tadorne-org/penon/site/content/en/_index.md

---
title: "Penon"
translationKey: home
description: "A no-moving-parts ultrasonic wind sensor, published as a commons. A Tadorne project."
params:
  hero:
    eyebrow: "A Tadorne project"
    lead: "The masthead wind sensor with no moving parts, corrected for the boat's motion. Open hardware, down to the silicon."
    ctas:
      - label: "The project"
        url: "/project/"
      - label: "Kit — coming soon"
        url: "mailto:contact@tadorne.org?subject=Penon%20%E2%80%94%20kit%20coming%20soon&body=Hello%2C%0A%0AI%27d%20be%20interested%20in%20the%20Penon%20kit%20when%20it%20becomes%20available.%0A%0AThanks."
        solid: true
  video:
    src: "/video/penon-rugged-en.mp4"
    poster: "/video/penon-rugged-en.webp"
    label: "Animated exploded view of the Penon wind sensor on its mast housing"
    caption: "Exploded view — rugged housing on a Ø50 mast. Electronics coming soon; figures are targets."
  figures:
    - label: "Moving parts"
      value: "0"
    - label: "Principle"
      value: "Ultrasound"
    - label: "Inertial unit"
      value: "Real time"
    - label: "Horizon"
      value: "Open silicon"
    - label: "Licence"
      value: "Free"
  notes:
    - title: "Bench first"
      body: "The physics is measured before anything is frozen."
    - title: "Open calibration"
      body: "The method nobody publishes — published."
    - title: "A reusable block"
      body: "The measurement core returns to open silicon, for more than wind."
  closing:
    title: "Join Penon"
    body: "Beta testers and contributors wanted. The bench is open; the mast comes this winter."
    url: "mailto:contact@tadorne.org?subject=Penon%20%E2%80%94%20beta%20testing%20%2F%20contribution&body=Hello%2C%0A%0AI%20would%20like%20to%20get%20involved%20in%20Penon.%0A%0AWhat%20I%20can%20bring%3A%0A-%0A%0AWhat%20I%20am%20looking%20for%3A%0A-%0A%0AThanks."
    label: "Write to us"
---

Wind, read in an ultrasonic field. Nothing to seize, nothing to wear.

The kit isn't available yet. Want to be notified? Get in touch at `contact@tadorne.org`.
