tadorne-org/penon/site/content/en/roadmap.md

---
title: "Roadmap"
translationKey: roadmap
url: /roadmap/
type: roadmap
description: "Eight milestones, published as they land."
params:
  milestones:
    - id: "M1"
      title: "Bench validated"
      body: "Resonance measured: frequency, quality factor, phase slope. Rig and method published."
    - id: "M2"
      title: "Prototypes"
      body: "Machined parts, revised board, ten assembled units."
    - id: "M3"
      title: "Open calibration"
      body: "Rig and correction tables, reproducible by third parties."
    - id: "M4"
      title: "Firmware v1"
      body: "Measurement, servo, motion compensation, quality flag."
    - id: "M5"
      title: "Measurement campaign"
      body: "Against a reference sensor; open dataset and accuracy report."
    - id: "M6"
      title: "RTL + FPGA"
      body: "The whole measurement chain validated on the real cavity, free toolchain."
    - id: "M7"
      title: "First silicon"
      body: "Shared-shuttle tapeout in an open process, analogue front-end on the die."
    - id: "M8"
      title: "Characterised IP block"
      body: "The phase-measurement core republished as a standalone, reusable block."
---

The physics is fixed first. Silicon starts early, because fabrication takes months.
