tadorne-org/penon/site/content/en/log/aluminium-resonance-cavity.md

---
title: "The aluminium resonance cavity, assembled"
translationKey: log/aluminium-cavity-assembled
date: 2026-10-02
description: "The two machined discs assembled into a cavity."
params:
  tags: ["penon", "mechanics"]
---

The two machined discs form the cavity: standoffs in place, screws around the rim, transducer openings clear. Ready for measurement.

<div class="photo-grid" style="column-width: 20rem">
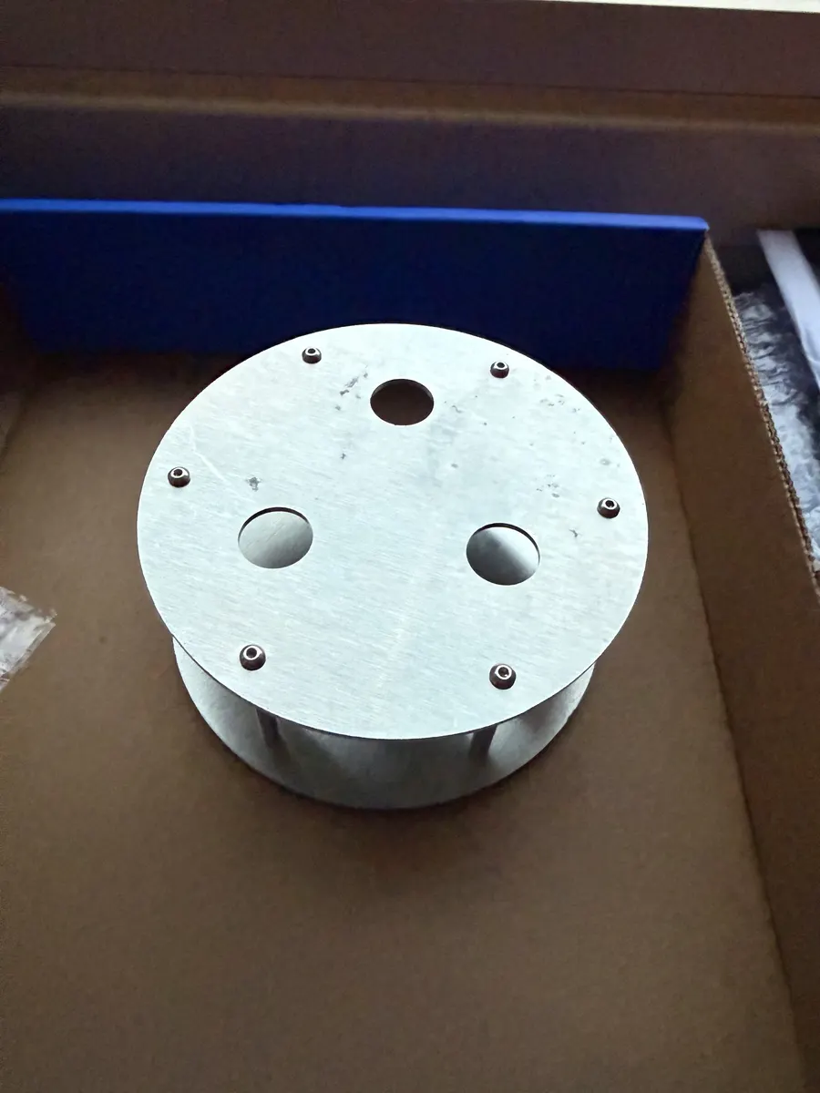
[picture p8: site/static/img/caisse-alu-01.webp]
The cavity seen from above: drilled top disc, screws around the rim.
  
  The assembled cavity at an angle: both discs and their standoffs.
</div>
