tadorne-org/penon/site/content/en/log/bench-first.md

---
title: "Bench first"
translationKey: log/bench-first
date: 2026-09-10
description: "The project opens at the bench, not in the water."
params:
  tags: ["penon", "measurement"]
---

The cavity goes under measurement first — frequency, quality factor, phase slope. The rig, the numbers and the failures will be published here.

<div class="photo-grid">
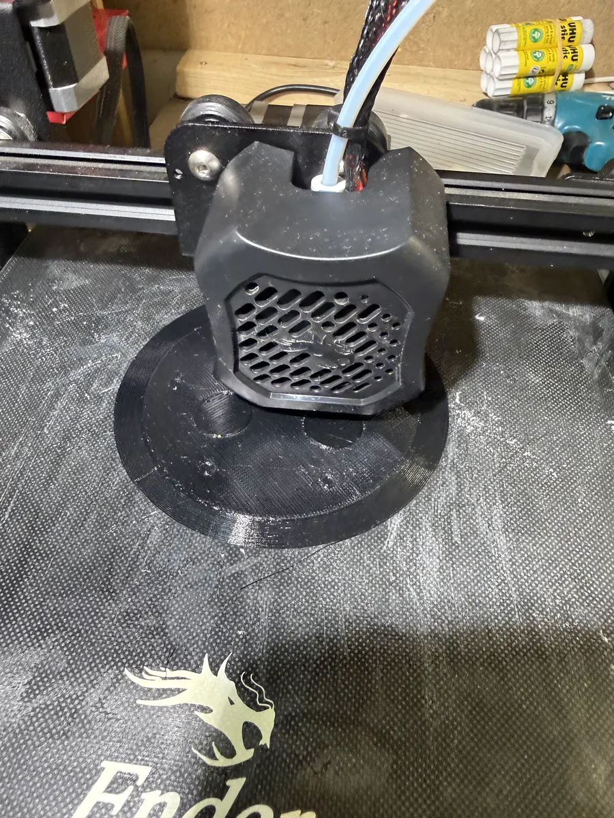
[picture p9: site/static/img/prototype-01.webp]
A printed disc on the 3D printer bed.
  
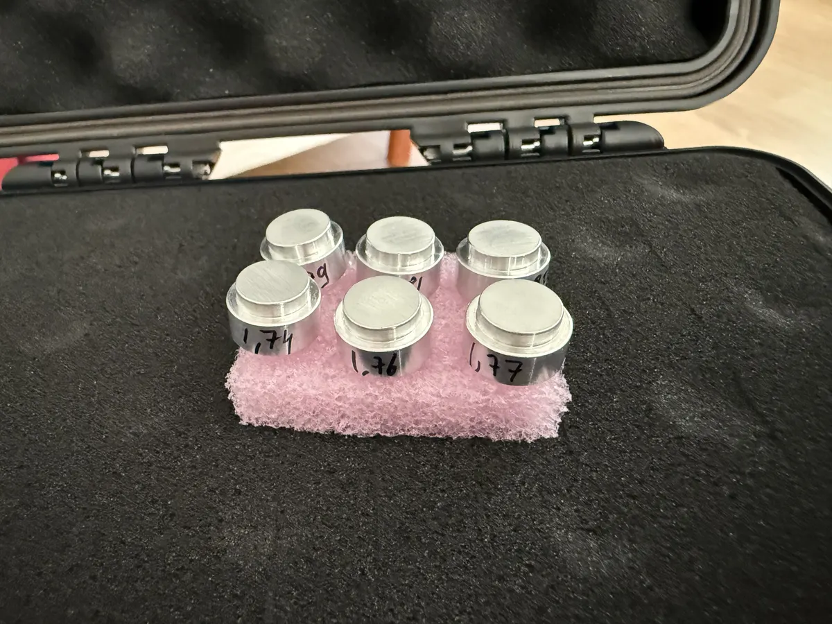
[picture p10: site/static/img/prototype-02.webp]
Six matched transducers, stored in their case.
  
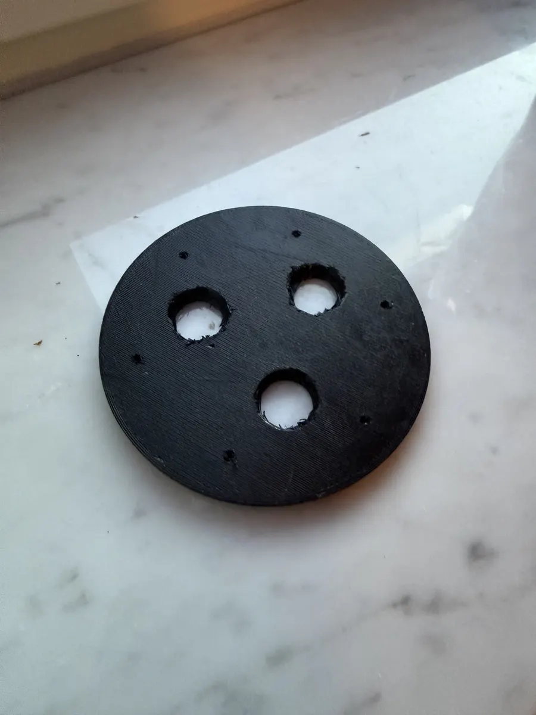
[picture p11: site/static/img/prototype-03.webp]
A printed disc, drilled for the transducers.
  
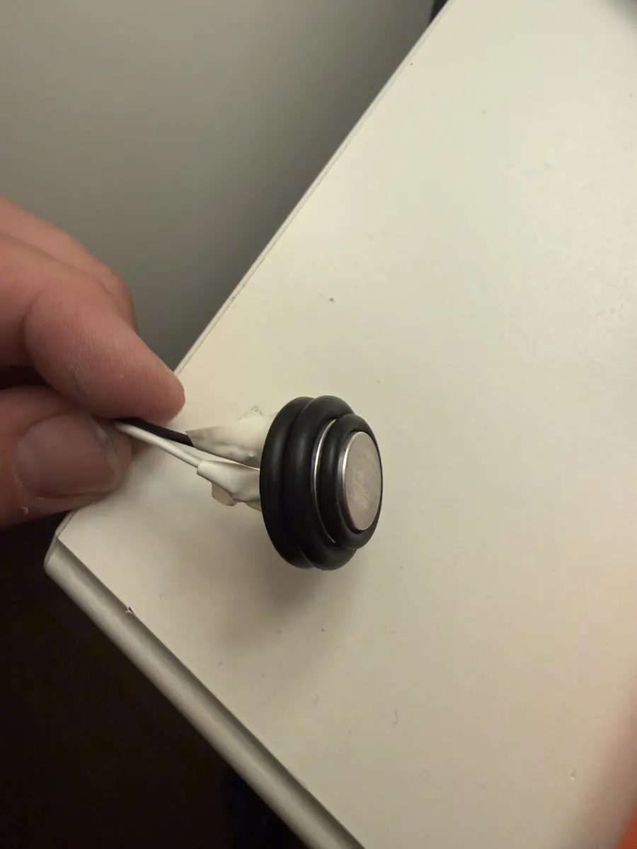
[picture p12: site/static/img/prototype-04.webp]
A transducer fitted into its printed ring.
  
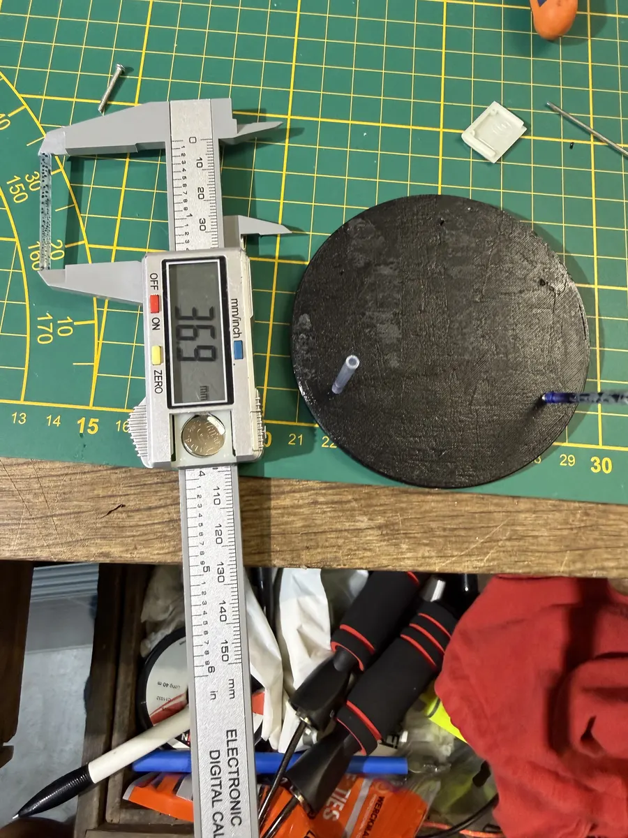
[picture p13: site/static/img/prototype-05.webp]
A printed disc checked with calipers.
  
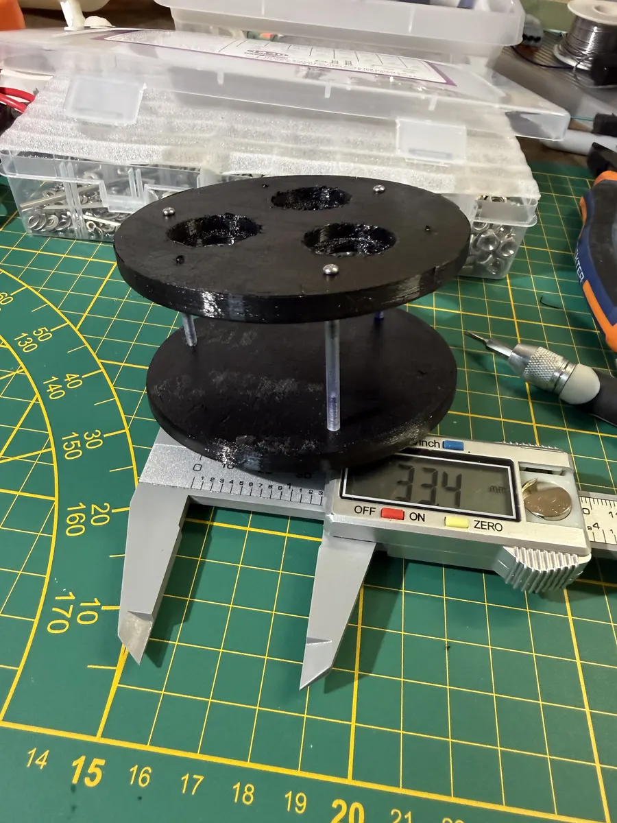
[picture p14: site/static/img/prototype-06.webp]
The two discs assembled on standoffs, measured with calipers.
  
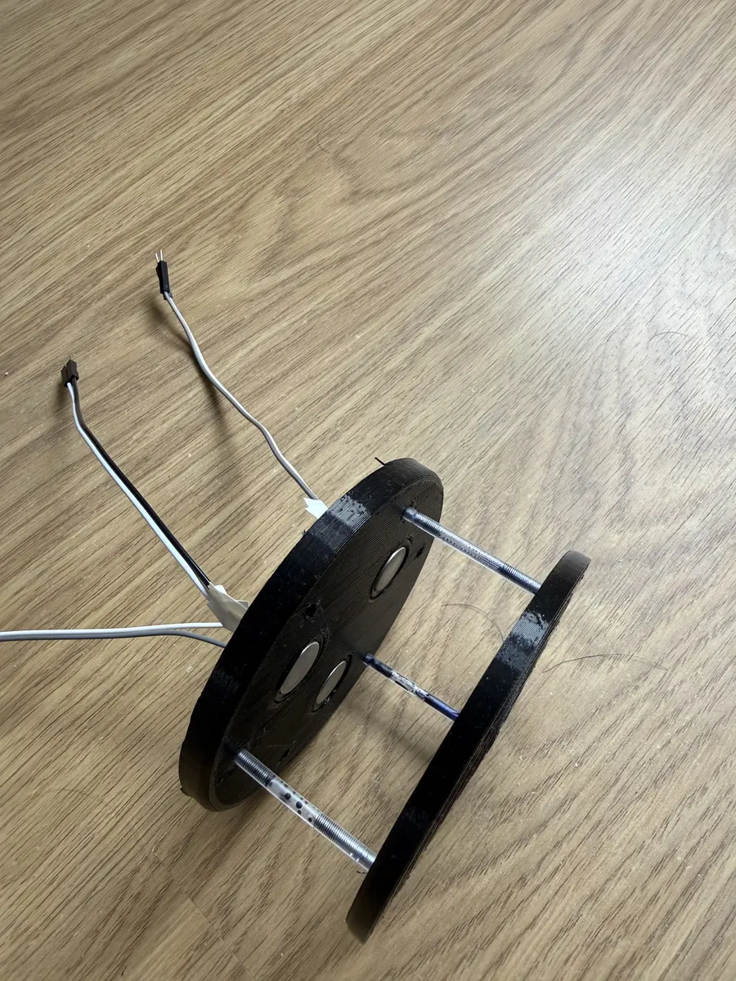
[picture p15: site/static/img/prototype-07.webp]
The wired assembly on the bench.
  
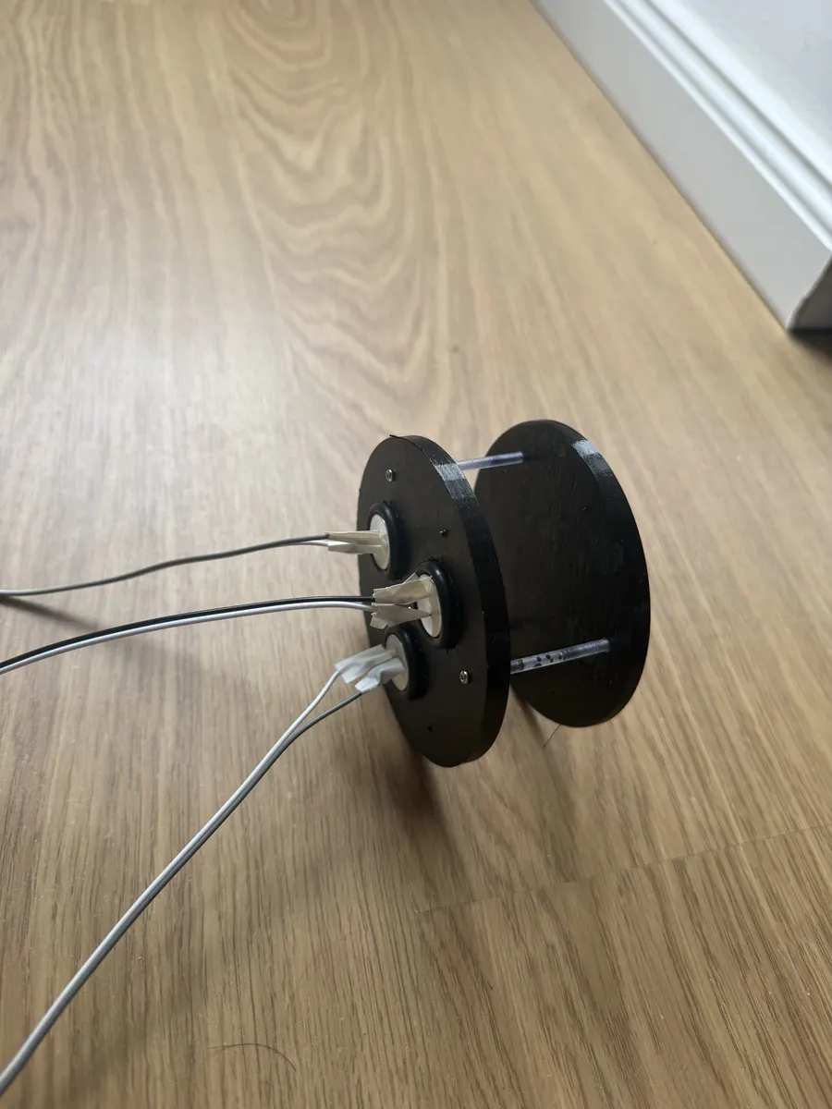
[picture p16: site/static/img/prototype-08.webp]
Three transducers bonded into the disc, wired.
  
</div>
