tadorne-org/penon/site/content/en/log/hardened-housing.md

---
title: "A hardened housing, printed in PETG"
translationKey: log/hardened-housing
date: 2026-10-05
description: "A ribbed housing, printed in PETG, replacing the broken structure."
params:
  tags: ["penon", "mechanics"]
---

The previous structure broke: too fragile. The new one is hardened — six ribs carry the crown down to the mast socket foot, with no cantilever left — and prints in PETG, inverted on the bed.

<div class="photo-grid">
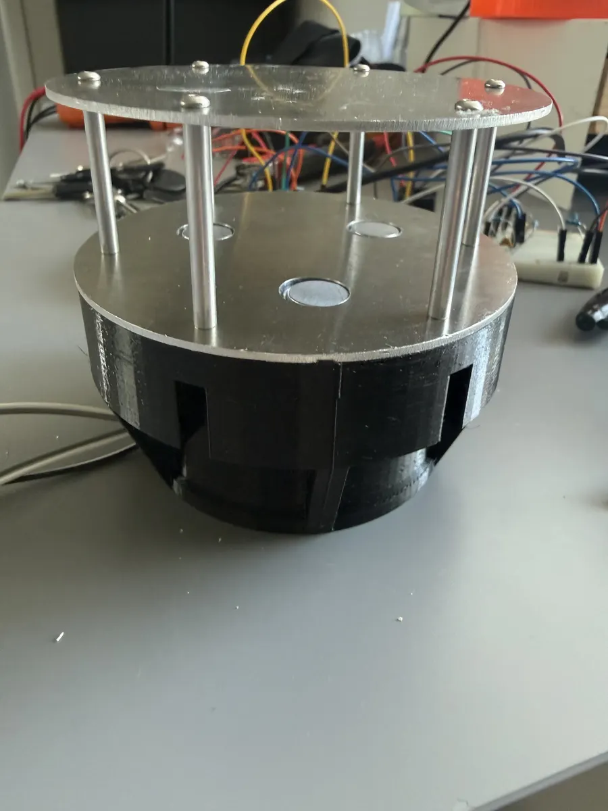
[picture p17: site/static/img/structure-durcie-01.webp]
The aluminium cavity mounted on the new ribbed housing.
  
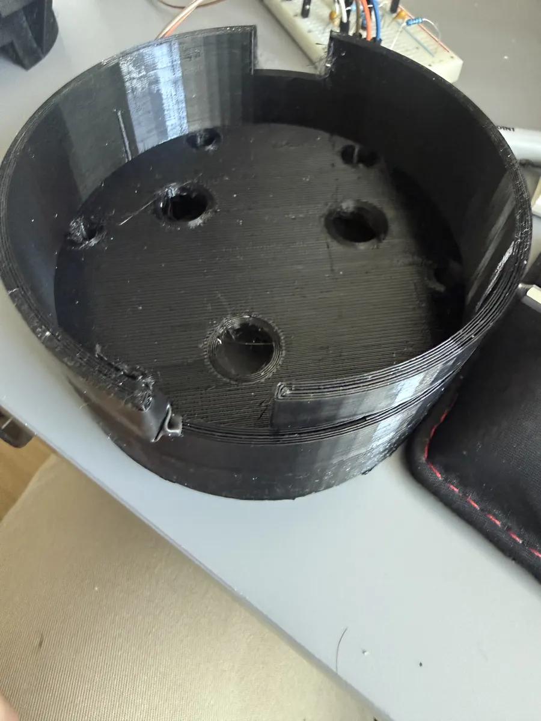
[picture p18: site/static/img/structure-durcie-02.webp]
The printed housing from above: transducer seats and ribs.
  
  The housing at an angle: the ribs carrying the crown down to the foot.
</div>
