tadorne-org/penon/site/content/en/log/resonance-frequency-search.md

---
title: "First tests on the resonance frequency and Q"
translationKey: log/resonance-frequency-search
date: 2026-09-16
description: "A frequency sweep on the printed cavity, signal picked up on the oscilloscope."
params:
  tags: ["penon", "measurement"]
---

The printed cavity goes on the bench: a frequency sweep around 40 kHz, the signal picked up on the oscilloscope. What remains is the resonance curve and Q.

<figure>
  The bench: printed cavity, breadboard and oscilloscope showing the drive signal.
</figure>

<figure>
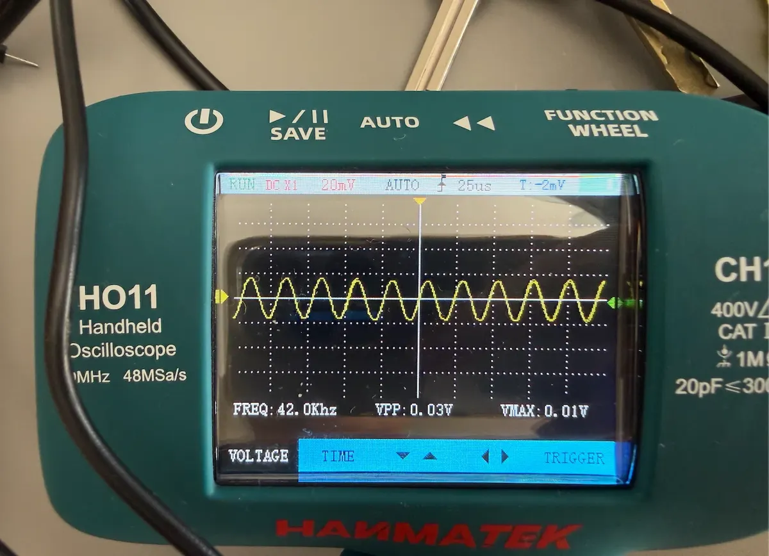
[picture p22: site/static/img/resonance-02.webp]
The oscilloscope screen showing the received signal, a sine wave.
  
</figure>
