tadorne-org/penon/site/content/en/log/thermal-drift.md

---
title: "Thermal drift measured: 75 Hz/°C"
translationKey: log/thermal-drift
date: 2026-10-04
description: "The resonance follows temperature at 75 Hz/°C."
params:
  tags: ["penon", "measurement"]
---

One night of recording, with no mechanical intervention: the resonance follows the room temperature at 75 Hz/°C, where the model predicted 70 — with no fitted parameter. Residuals fall to the level of the bench's measurement floor: the relation is explained down to what the instrument can resolve.

<figure>
  Two panels: on the left the resonance frequency and temperature through the night; on the right frequency against temperature with the regression.
</figure>
