tadorne-org/penon/site/content/en/log/tpu-sole.md

---
title: "The TPU sole is ready"
translationKey: log/tpu-sole
date: 2026-10-07
description: "TPU tuning, sole printed; on to the bench."
params:
  tags: ["penon", "mechanics"]
---

After several TPU-specific adjustments, the sole prints very satisfactorily. On to the bench tests.

<div class="photo-grid">
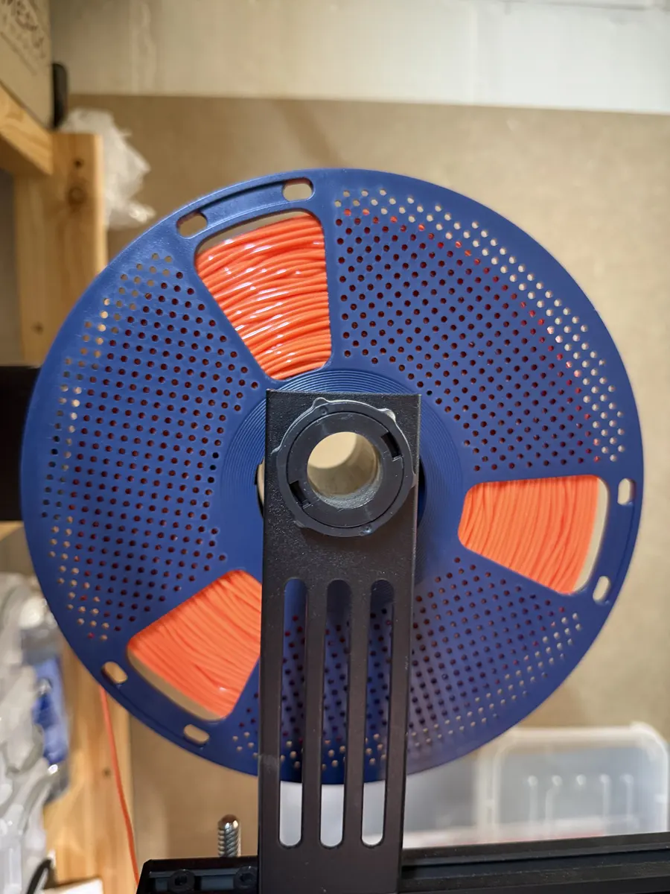
[picture p23: site/static/img/semelle-tpu-01.webp]
The orange TPU spool on its holder.
  
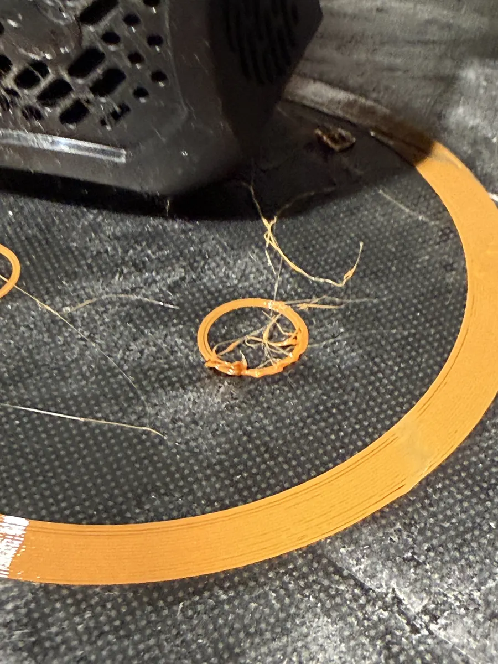
[picture p24: site/static/img/semelle-tpu-02.webp]
First attempt: strings and blobs on the bed.
  
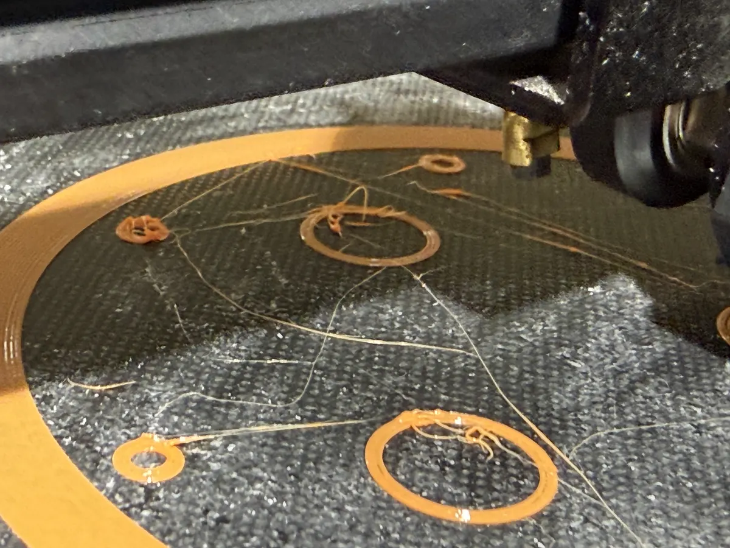
[picture p25: site/static/img/semelle-tpu-03.webp]
The bed after an attempt: several parts and a lot of stringing.
  
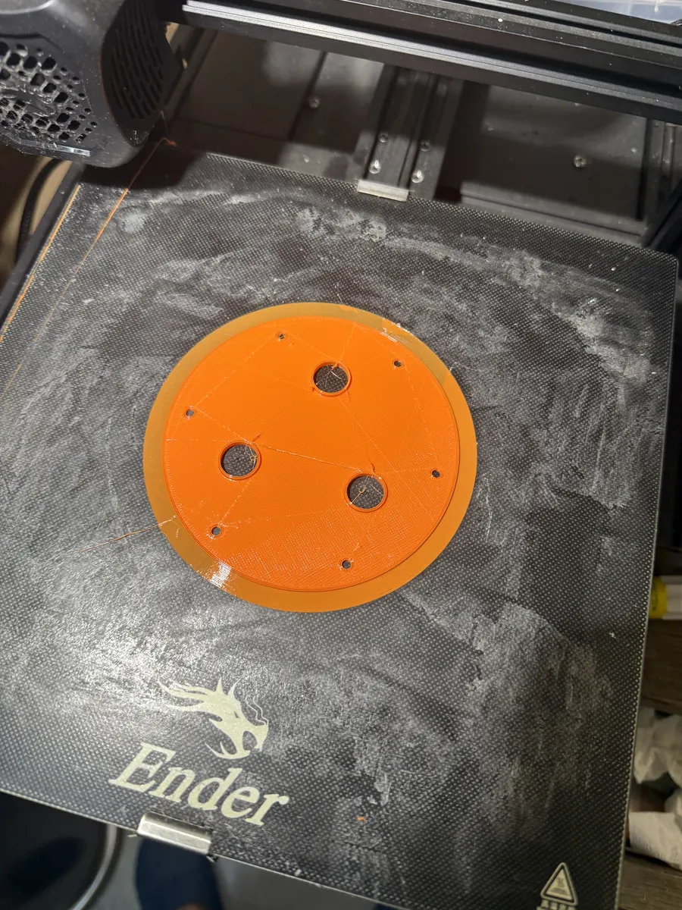
[picture p26: site/static/img/semelle-tpu-04.webp]
The sole being printed on the bed.
  
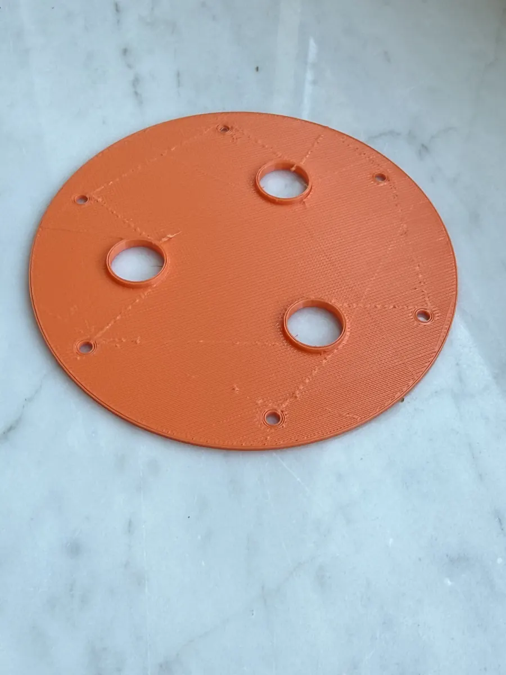
[picture p27: site/static/img/semelle-tpu-05.webp]
The finished TPU sole, on the marble.
  
  The sole in place between the aluminium cavity and the housing.
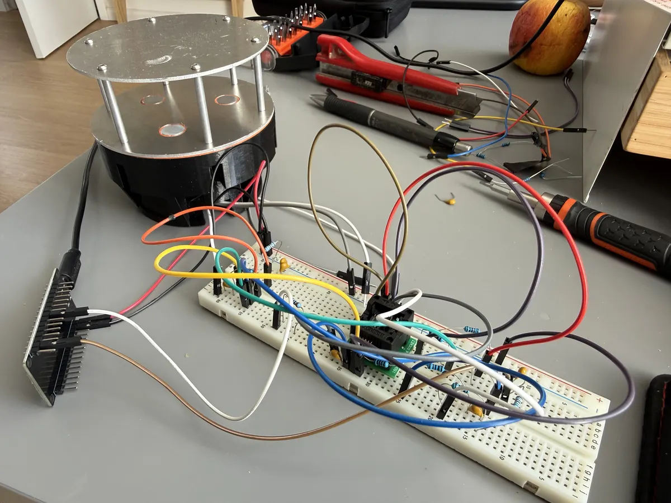
[picture p28: site/static/img/semelle-tpu-07.webp]
The full bench, ready for testing.
  
</div>
