tadorne-org/penon/site/content/en/log/why-open-silicon.md

---
title: "Why open silicon"
translationKey: log/why-open-silicon
date: 2026-09-08
description: "A measurement core that one supplier could retire."
params:
  tags: ["penon", "silicon"]
---

The measurement chain rests on parts a single supplier can discontinue. The answer is a free, characterised core — reused far beyond wind.
