tadorne-org/penon/site/content/en/about.md

---
title: "About"
translationKey: about
url: /about/
description: "Penon is a Tadorne project."
---

**Tadorne** — *duck engineering* — designs and publishes open hardware: electronics, mechanics, firmware, silicon. Penon is its first project.

Everything published is signed with a single GPG key, anchored in the DNS of `tadorne.org`:

<code class="fingerprint">5420 08E3 53EC A628 B4D6  ACAD 8C03 243A FF69 5BF7</code>

[How to verify a publication](https://tadorne.org/verify/) · `contact@tadorne.org`
