tadorne-org/penon/site/content/fr/_index.md

---
title: "Penon"
translationKey: home
description: "Anémomètre ultrasonique sans pièce mobile, publié comme un commun. Un projet Tadorne."
params:
  hero:
    eyebrow: "Un projet Tadorne"
    lead: "L'anémomètre de tête de mât sans aucune pièce mobile, corrigé du mouvement du bateau. Matériel libre, jusqu'au silicium."
    ctas:
      - label: "Le projet"
        url: "/fr/projet/"
      - label: "Kit — bientôt disponible"
        url: "mailto:contact@tadorne.org?subject=Penon%20%E2%80%94%20kit%20%C3%A0%20venir&body=Bonjour%2C%0A%0AJe%20serais%20int%C3%A9ress%C3%A9%20par%20le%20kit%20Penon%20lorsqu%27il%20sera%20disponible.%0A%0AMerci."
        solid: true
  video:
    src: "/video/penon-durci-fr.mp4"
    poster: "/video/penon-durci-fr.webp"
    label: "Vue éclatée animée de l'anémomètre Penon sur son boîtier de mât"
    caption: "Vue éclatée — boîtier durci sur mât Ø50. Électronique à venir ; les chiffres sont des objectifs."
  figures:
    - label: "Pièces mobiles"
      value: "0"
    - label: "Principe"
      value: "Ultrasons"
    - label: "Centrale inertielle"
      value: "Temps réel"
    - label: "Horizon"
      value: "Silicium libre"
    - label: "Licence"
      value: "Libre"
  notes:
    - title: "Le banc d'abord"
      body: "La physique est mesurée avant d'être figée."
    - title: "Étalonnage ouvert"
      body: "La méthode que personne ne publie — publiée."
    - title: "Un bloc réutilisable"
      body: "Le cœur de mesure retourne au silicium libre, au-delà du vent."
  closing:
    title: "Rejoindre Penon"
    body: "Bêta-testeurs et contributeurs recherchés. Le banc est ouvert, le mât vient cet hiver."
    url: "mailto:contact@tadorne.org?subject=Penon%20%E2%80%94%20b%C3%AAta-test%20%2F%20contribution&body=Bonjour%2C%0A%0AJe%20souhaite%20m%27impliquer%20dans%20Penon.%0A%0ACe%20que%20je%20peux%20apporter%20%3A%0A-%0A%0ACe%20que%20je%20cherche%20%3A%0A-%0A%0AMerci."
    label: "Écrire"
---

Le vent, lu dans un champ ultrasonore. Rien qui se grippe, rien qui s'use.

Le kit n'est pas encore disponible. Vous souhaitez être prévenu ? Contactez-nous à `contact@tadorne.org`.
