tadorne-org/penon/site/content/fr/a-propos.md

---
title: "À propos"
translationKey: about
url: /fr/a-propos/
description: "Penon est un projet Tadorne."
---

**Tadorne** — *duck engineering* — conçoit et publie du matériel libre : électronique, mécanique, micrologiciel, silicium. Penon est son premier projet.

Tout ce qui est publié est signé par une clé GPG unique, ancrée dans le DNS de `tadorne.org` :

<code class="fingerprint">5420 08E3 53EC A628 B4D6  ACAD 8C03 243A FF69 5BF7</code>

[Comment vérifier une publication](https://tadorne.org/verifier/) · `contact@tadorne.org`
