tadorne-org/penon/site/content/fr/feuille-de-route.md

---
title: "Feuille de route"
translationKey: roadmap
url: /fr/feuille-de-route/
type: roadmap
description: "Huit jalons, publiés au fur et à mesure."
params:
  milestones:
    - id: "M1"
      title: "Banc validé"
      body: "Résonance mesurée : fréquence, facteur de qualité, pente de phase. Banc et méthode publiés."
    - id: "M2"
      title: "Prototypes"
      body: "Pièces usinées, carte révisée, dix exemplaires assemblés."
    - id: "M3"
      title: "Étalonnage ouvert"
      body: "Platine et tables de correction, reproductibles par des tiers."
    - id: "M4"
      title: "Micrologiciel v1"
      body: "Mesure, asservissement, compensation du mouvement, drapeau de qualité."
    - id: "M5"
      title: "Campagne de mesure"
      body: "Face à un capteur de référence ; jeu de données ouvert et rapport de précision."
    - id: "M6"
      title: "RTL + FPGA"
      body: "Toute la chaîne de mesure validée sur la cavité réelle, chaîne d'outils libre."
    - id: "M7"
      title: "Premier silicium"
      body: "Tapeout en navette partagée sur procédé ouvert, front-end analogique sur la puce."
    - id: "M8"
      title: "Bloc IP caractérisé"
      body: "Le cœur de mesure de phase republié en bloc autonome et réutilisable."
---

La physique est figée d'abord. Le silicium démarre tôt, la fabrication prenant des mois.
