tadorne-org/penon/site/content/fr/projet.md

---
title: "Le projet"
translationKey: project
url: /fr/projet/
description: "Un capteur de vent sans pièce mobile, et une route vers le silicium libre."
params:
  eyebrow: "Penon"
---

## Le problème

Un capteur de tête de mât est une pièce qui casse — et le marché qui le remplace est fermé.

## L'approche

Le vent se lit dans la manière dont il perturbe un champ ultrasonore entre des transducteurs fixes. La mesure est réciproque : le milieu s'annule, il reste le vent. Rien ne bouge.

## Le mouvement

Une tête de mât bouge — roulis, tangage, accélération. Une centrale inertielle embarquée corrige la mesure en temps réel : ce qui arrive au barreur est le vent, pas le mouvement du bateau.

## L'horizon

Un instrument ouvert de bout en bout — et, au bout du chemin, les puces à signaux mixtes qui en forment le cœur, refaites en silicium libre. Le cœur de mesure retourne aux communs comme bloc réutilisable.

## Licence

Annoncée à la première publication. Visées : licences libres, matériel et micrologiciel.
