tadorne-org/penon/site/content/en/log/first-prototype-parts.md

---
title: "First prototype parts"
translationKey: log/first-prototype-parts
date: 2026-09-10
description: "The first resonance prototype discs come off the printer."
params:
  viewer: true
  tags: ["penon", "resonance", "prototype"]
---

The first prototype discs are printed in PETG. The cavity goes to the bench
as soon as the transducers are in place.

{{< viewer src="/models/disque_bas_proto.glb" label="Lower disc — three transducer bores" >}}

{{< viewer src="/models/disque_haut_proto.glb" label="Upper disc — reflector" >}}

{{< viewer src="/models/eclate_cusa.glb" label="Exploded view — transducer and O-rings" >}}

{{< photo src="img/journal/lot-usine.png" alt="Six machined aluminium parts on pink foam in a case" caption="The machined batch, measured one by one." >}}

{{< photo src="img/journal/impression-disque.png" alt="A black PETG disc on the printer bed" caption="The lower disc on the bed." >}}

{{< photo src="img/journal/disque-transducteurs.png" alt="Printed disc with three transducers fitted flush" caption="Printed disc, transducers in place." >}}
