tadorne-org/penon/site/content/en/log/first-print.md

---
title: "First 3D print of a time-of-flight version"
translationKey: log/3d-printed-prototype
date: 2026-08-26
description: "The prototype comes off the printer."
params:
  tags: ["penon", "mechanics"]
---

<figure>
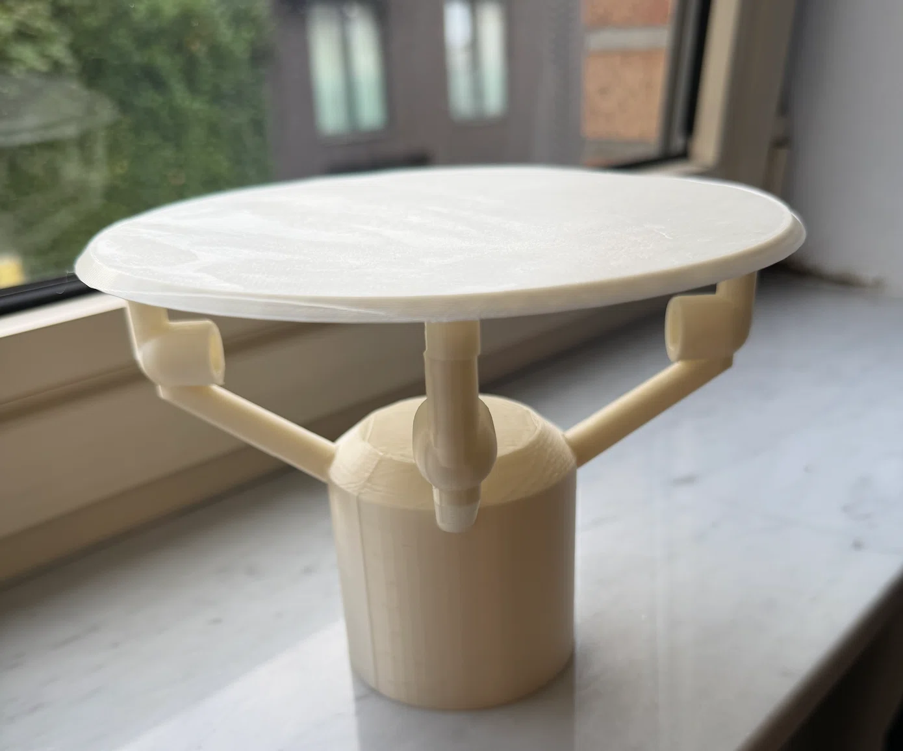
[picture p29: site/static/img/prototype.webp]
A 3D-printed mechanical prototype resting on a window sill.
  
</figure>

The prototype, the failures and the corrections will be published here.
