tadorne-org/penon/site/content/en/log/first-bench-results.md

---
title: "First bench results: Q = 287"
translationKey: log/bench-results-q
date: 2026-10-02
description: "Q measured at 287 on the aluminium cavity — ten times the assumption."
params:
  tags: ["penon", "measurement"]
---

The aluminium cavity resonates at 39.7 kHz with a Q of 287 — ten times the working assumption. Mode spacing returns the mechanical gap with no fitted parameter, and the Lorentzian predicts the off-resonance amplitude to within 2%.

<div class="photo-grid">
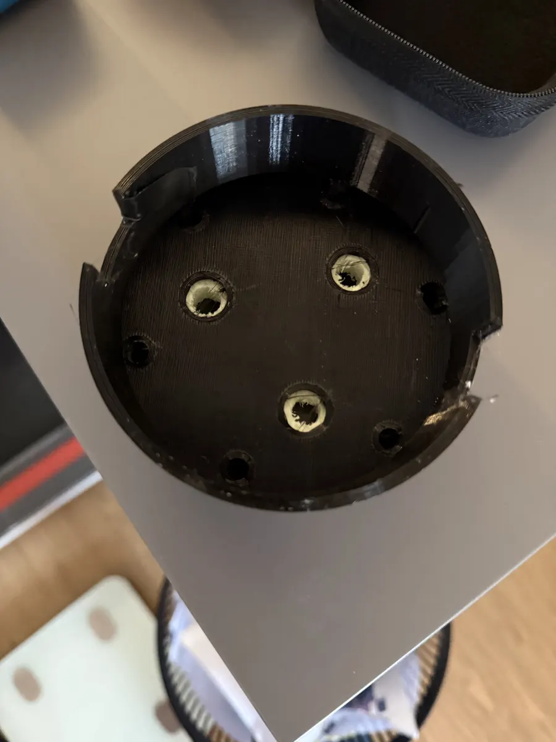
[picture p30: site/static/img/banc-q-01.webp]
The printed housing and its three inserts, seen from above.
  
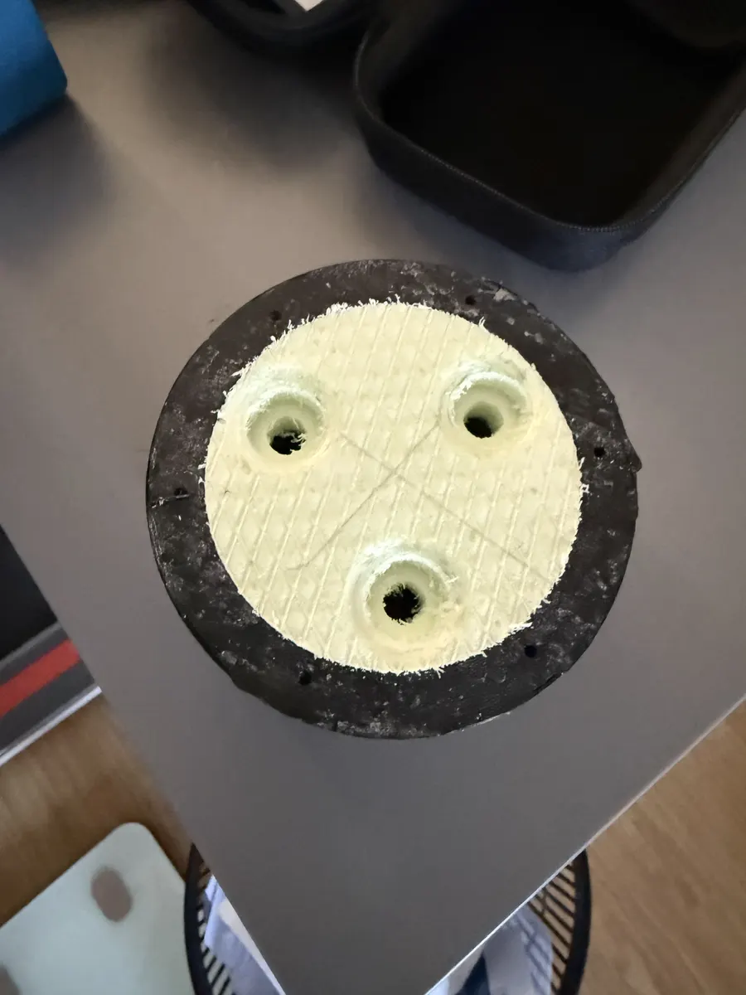
[picture p31: site/static/img/banc-q-02.webp]
The housing lined with foam, drilled for the three transducers.
  
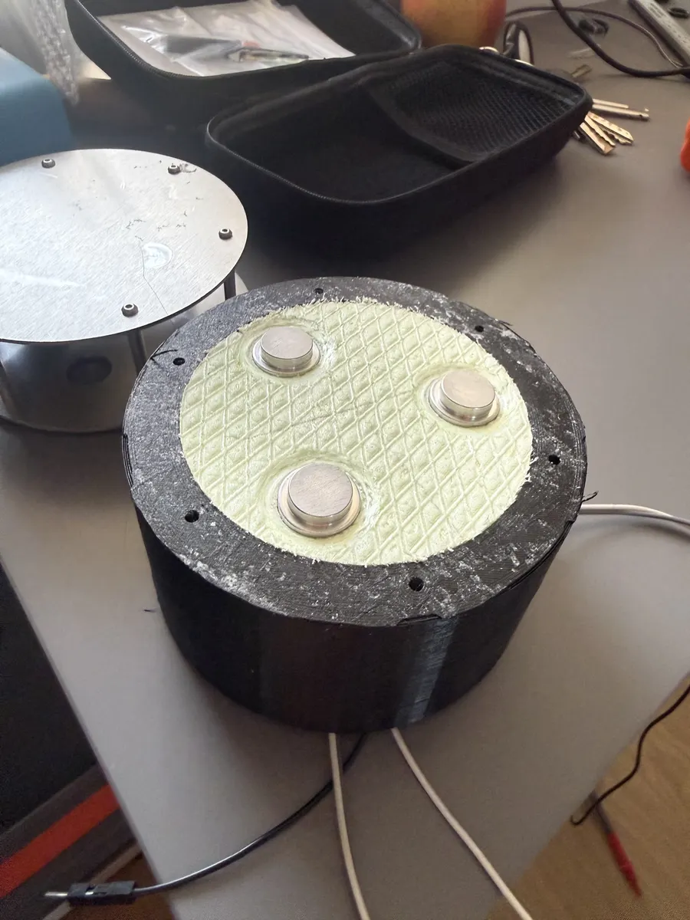
[picture p32: site/static/img/banc-q-03.webp]
The three transducers set in the foam, next to the aluminium cavity.
  
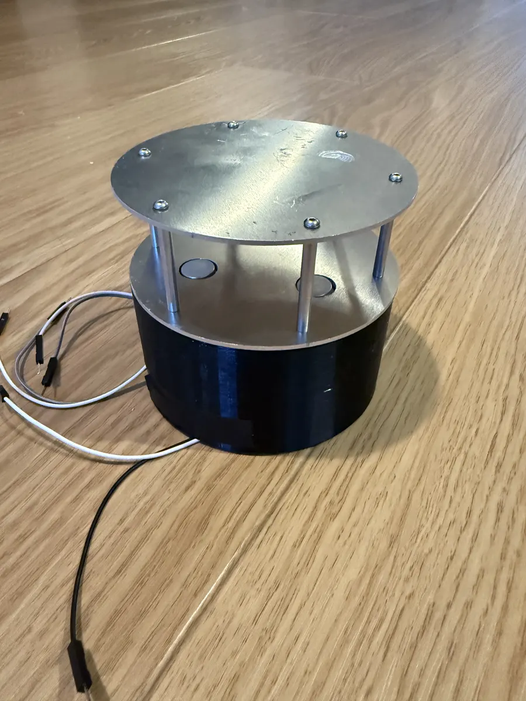
[picture p33: site/static/img/banc-q-04.webp]
The aluminium cavity mounted on the transducer housing.
  
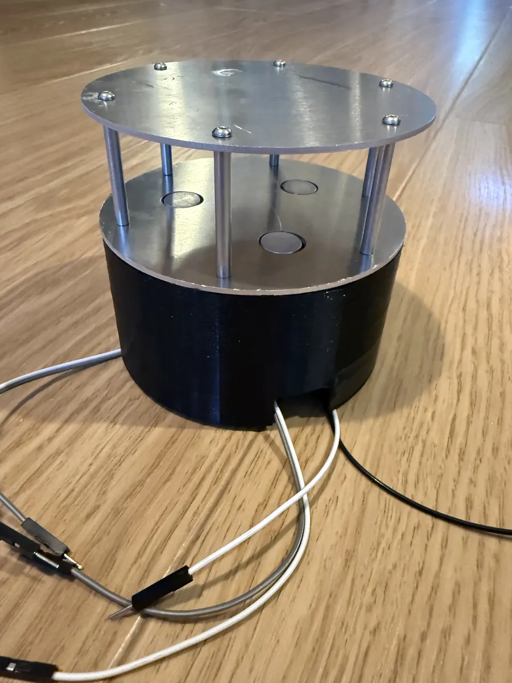
[picture p34: site/static/img/banc-q-05.webp]
The assembled cavity at an angle: discs, standoffs and wiring.
  
  The full bench: cavity, breadboard and oscilloscope.
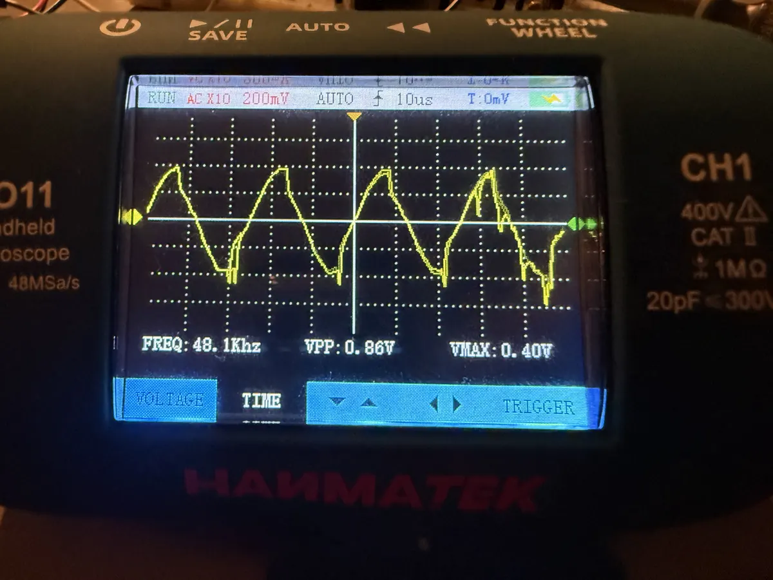
[picture p35: site/static/img/banc-q-07.webp]
The oscilloscope screen: the signal at resonance, with the notch on the falling edge.
  
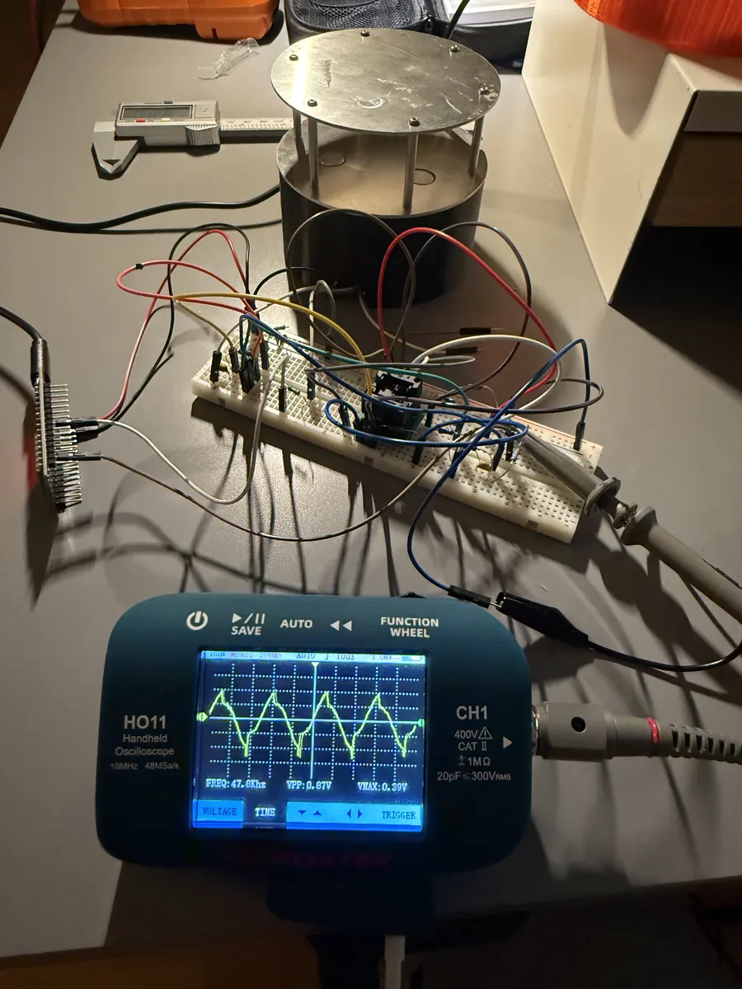
[picture p36: site/static/img/banc-q-08.webp]
The bench from above: cavity, circuit and an off-resonance reading.
  
</div>
