tadorne-org/penon/site/content/en/log/first-opamp-test.md

---
title: "First test with the op-amp"
translationKey: log/opamp-first-test
date: 2026-09-18
description: "The amplification stage on the breadboard."
params:
  tags: ["penon", "measurement"]
---

The amplification stage joins the chain: the whole setup now fits on the breadboard, from drive to reception. First test, first readings.

<figure>
  The breadboard setup: the amplification stage and the links to the cavity.
</figure>
