tadorne-org/penon/site/content/fr/journal/premier-test-ampli-op.md

---
title: "Premier test avec ampli-op"
translationKey: log/opamp-first-test
date: 2026-09-18
description: "L'étage d'amplification monté sur la plaque d'essai."
params:
  tags: ["penon", "mesure"]
---

L'étage d'amplification entre dans la chaîne : le montage complet tient sur la plaque d'essai, de l'émission à la réception. Premier test, premiers relevés.

<figure>
  Le montage sur la plaque d'essai : l'étage d'amplification et les liaisons vers la cavité.
</figure>
