tadorne-org/penon/site/content/fr/journal/premiers-resultats-banc.md

---
title: "Premiers résultats du banc : Q = 287"
translationKey: log/bench-results-q
date: 2026-10-02
description: "Q mesuré à 287 sur la cavité aluminium — dix fois l'hypothèse."
params:
  tags: ["penon", "mesure"]
---

La cavité aluminium résonne à 39,7 kHz, avec un Q de 287 — dix fois l'hypothèse de travail. L'écart entre modes redonne la distance mécanique sans aucun paramètre ajusté, et la lorentzienne prédit l'amplitude hors résonance à 2 % près.

<div class="photo-grid">
  Le logement imprimé et ses trois inserts, vu de dessus.
  Le logement garni de mousse, percé pour les trois sondes.
  Les trois sondes en place dans la mousse, à côté de la cavité aluminium.
  La cavité aluminium montée sur le logement des sondes.
  La cavité assemblée, vue de biais : disques, entretoises et câblage.
  Le banc complet : cavité, plaque d'essai et oscilloscope.
  L'écran de l'oscilloscope : le signal à la résonance, avec le décrochement en descente.
  Le banc vu de dessus : cavité, montage et relevé hors résonance.
</div>
