tadorne-org/penon/site/content/fr/journal/caisse-resonance-alu.md

---
title: "La caisse de résonance assemblée en aluminium"
translationKey: log/aluminium-cavity-assembled
date: 2026-10-02
description: "Les deux disques usinés réunis en caisse."
params:
  tags: ["penon", "mécanique"]
---

Les deux disques usinés forment la caisse : entretoises en place, vis au pourtour, ouvertures des sondes dégagées. Prête pour la mesure.

<div class="photo-grid" style="column-width: 20rem">
  La caisse vue de dessus : disque supérieur percé, vis au pourtour.
  La caisse assemblée vue de biais : les deux disques et leurs entretoises.
</div>
