tadorne-org/penon/site/content/fr/journal/derive-thermique.md

---
title: "Dérive thermique mesurée : 75 Hz/°C"
translationKey: log/thermal-drift
date: 2026-10-04
description: "La résonance suit la température à 75 Hz/°C."
params:
  tags: ["penon", "mesure"]
---

Une nuit d'enregistrement, sans intervention mécanique : la résonance suit la température de la pièce à 75 Hz/°C, quand le modèle en prévoyait 70 — sans aucun paramètre ajusté. Les résidus tombent au niveau du plancher du banc : la relation est expliquée jusqu'à ce que l'instrument sait résoudre.

<figure>
  Deux panneaux : à gauche la fréquence de résonance et la température au fil de la nuit ; à droite la fréquence en fonction de la température, avec la régression.
</figure>
