tadorne-org/penon/site/content/fr/journal/le-banc-d-abord.md

---
title: "Le banc d'abord"
translationKey: log/bench-first
date: 2026-09-10
description: "Le projet s'ouvre à l'établi, pas à l'eau."
params:
  tags: ["penon", "mesure"]
---

La cavité passe d'abord sous la mesure — fréquence, facteur de qualité, pente de phase. Le banc, les chiffres et les ratés seront publiés ici.

<div class="photo-grid">
  Un disque imprimé sur le plateau de l'imprimante 3D.
  Six sondes appariées, rangées dans leur boîte.
  Disque imprimé, percé pour les sondes.
  Une sonde montée dans sa bague imprimée.
  Contrôle au pied à coulisse d'un disque imprimé.
  Les deux disques assemblés sur entretoises, mesurés au pied à coulisse.
  L'assemblage câblé, posé sur l'établi.
  Trois sondes collées dans le disque, câblées.
</div>
