tadorne-org/penon/site/content/fr/journal/premiere-impression.md

---
title: "Première impression 3D d'une version Time Of Flight"
translationKey: log/3d-printed-prototype
date: 2026-08-26
description: "Le prototype sort de l'imprimante."
params:
  tags: ["penon", "mécanique"]
---

<figure>
  Prototype mécanique imprimé en 3D, posé sur un rebord de fenêtre.
</figure>

Le prototype, les ratés et les corrections seront publiés ici.
