tadorne-org/penon/site/content/fr/journal/premieres-pieces-proto.md

---
title: "Premières pièces du prototype"
translationKey: log/first-prototype-parts
date: 2026-09-10
description: "Les premiers disques du prototype résonance sortent de l'imprimante."
params:
  viewer: true
  tags: ["penon", "résonance", "proto"]
---

Les premiers disques du prototype sont imprimés en PETG. La cavité part au
banc dès que les transducteurs sont en place.

{{< viewer src="/models/disque_bas_proto.glb" label="Disque bas — logements des trois transducteurs" >}}

{{< viewer src="/models/disque_haut_proto.glb" label="Disque haut — réflecteur" >}}

{{< viewer src="/models/eclate_cusa.glb" label="Vue éclatée — transducteur et joints toriques" >}}

{{< photo src="img/journal/lot-usine.png" alt="Six pièces usinées en aluminium posées sur de la mousse rose, dans une mallette" caption="Le lot usiné, mesuré pièce par pièce." >}}

{{< photo src="img/journal/impression-disque.png" alt="Un disque noir en PETG sur le plateau de l'imprimante" caption="Le disque bas sur le plateau." >}}

{{< photo src="img/journal/disque-transducteurs.png" alt="Disque imprimé, trois transducteurs montés à fleur de la face" caption="Disque imprimé, transducteurs en place." >}}
