tadorne-org/penon/site/content/fr/journal/semelle-tpu.md

---
title: "La semelle TPU est prête"
translationKey: log/tpu-sole
date: 2026-10-07
description: "Réglages TPU, semelle imprimée ; place au banc."
params:
  tags: ["penon", "mécanique"]
---

Après plusieurs réglages spécifiques au TPU, l'impression de la semelle est très satisfaisante. Place aux tests sur le banc.

<div class="photo-grid">
  La bobine de TPU orange sur son support.
  Premier essai : fils et bavures sur le plateau.
  Le plateau après un essai : plusieurs pièces et beaucoup de fils.
  La semelle en cours d'impression sur le plateau.
  La semelle TPU terminée, posée sur le marbre.
  La semelle en place entre la cavité aluminium et le boîtier.
  Le banc complet, prêt pour les tests.
</div>
