tadorne-org/penon/site/content/fr/journal/_index.md

---
title: "Journal"
translationKey: log
type: log
description: "Notes courtes, pendant que le travail se fait."
cascade:
  type: log
---

Publié tel que mesuré.
