tadorne-org/penon/site/content/fr/journal/boitier-durci.md

---
title: "Un boîtier durci, imprimé en PETG"
translationKey: log/hardened-housing
date: 2026-10-05
description: "Boîtier nervuré, imprimé en PETG, à la place de la structure cassée."
params:
  tags: ["penon", "mécanique"]
---

La structure précédente a cassé : trop fragile. La nouvelle est durcie — six nervures reprennent la couronne jusqu'au pied de la douille de mât, sans plus aucun porte-à-faux — et s'imprime en PETG, retournée sur le plateau.

<div class="photo-grid">
  La cavité aluminium montée sur le nouveau boîtier nervuré.
  Le boîtier imprimé vu de dessus : logements des sondes et nervures.
  Le boîtier vu de biais : les nervures qui reprennent la couronne jusqu'au pied.
</div>
