tadorne-org/penon/site/content/fr/journal/pourquoi-le-silicium-libre.md

---
title: "Pourquoi le silicium libre"
translationKey: log/why-open-silicon
date: 2026-09-08
description: "Un cœur de mesure qu'un seul fournisseur pourrait retirer."
params:
  tags: ["penon", "silicium"]
---

La chaîne de mesure repose sur des pièces qu'un fournisseur unique peut arrêter. La réponse est un cœur libre et caractérisé — réutilisé bien au-delà du vent.
