tadorne-org/penon/site/content/fr/journal/recherche-frequence-resonance.md

---
title: "Premiers tests sur la recherche de la fréquence de résonance et Q"
translationKey: log/resonance-frequency-search
date: 2026-09-16
description: "Balayage en fréquence sur la cavité imprimée, signal reçu à l'oscilloscope."
params:
  tags: ["penon", "mesure"]
---

La cavité imprimée passe au banc : balayage en fréquence autour de 40 kHz, signal reçu à l'oscilloscope. Reste à tracer la courbe de résonance et à en sortir Q.

<figure>
  Le banc : cavité imprimée, plaque d'essai et oscilloscope affichant le signal d'émission.
</figure>

<figure>
  L'écran de l'oscilloscope montrant le signal reçu, sinusoïdal.
</figure>
