tadorne-org/penon/site/assets/img/journal/disque-transducteurs.png

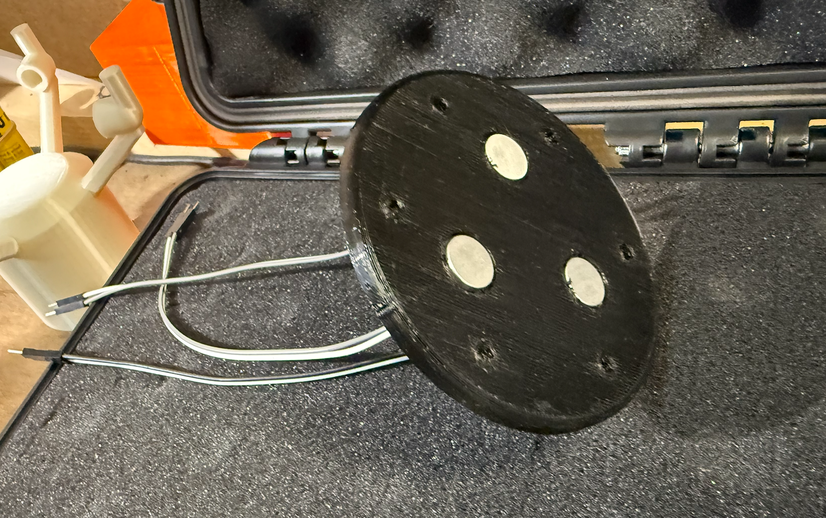
site/assets/img/journal/disque-transducteurs.png
