tadorne-org/penon/site/assets/img/journal/impression-disque.png

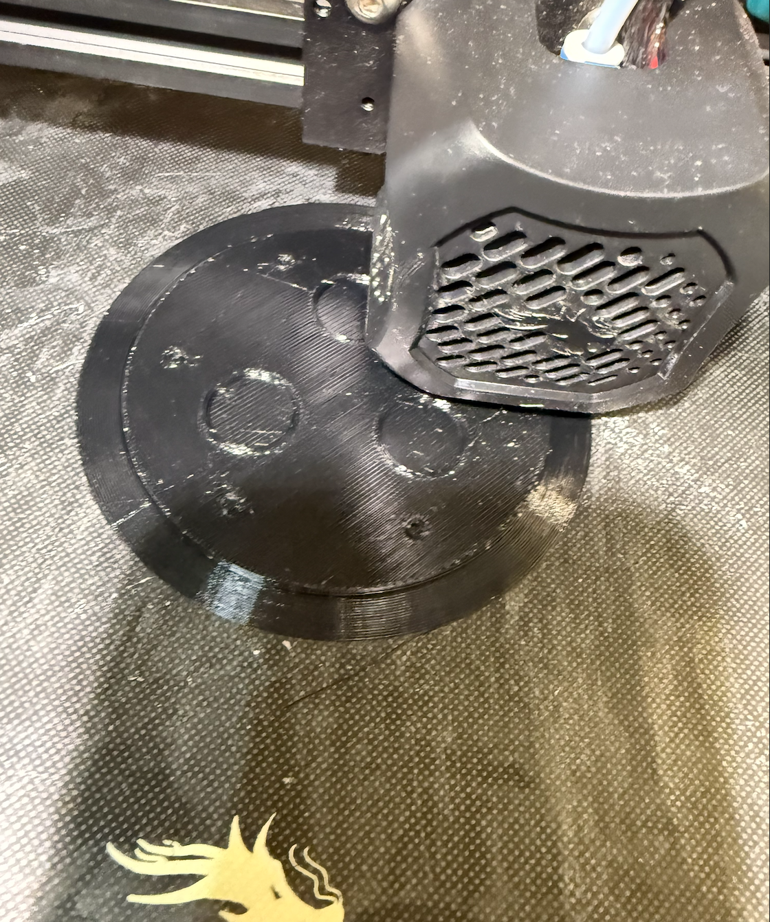
site/assets/img/journal/impression-disque.png
