tadorne-org/penon/site/assets/img/journal/lot-usine.png

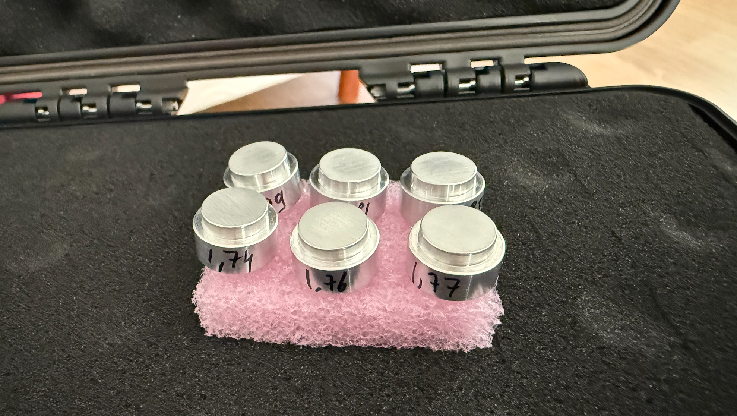
site/assets/img/journal/lot-usine.png
